MalyshkoA/agents-usage-and-limits-monitor/docs/images/desk-control.jpg

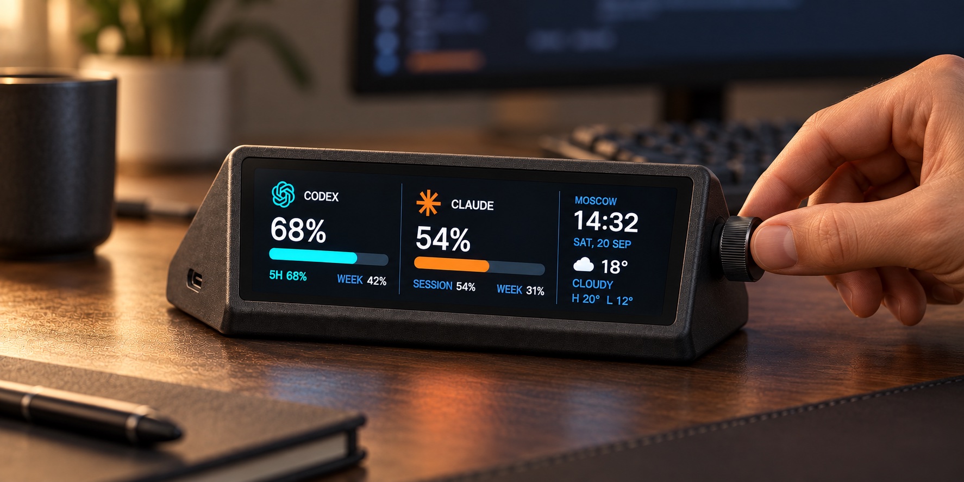
docs/images/desk-control.jpg
