MalyshkoA/agents-usage-and-limits-monitor/enclosure/exports-r4/asb-r4-board-mount.png

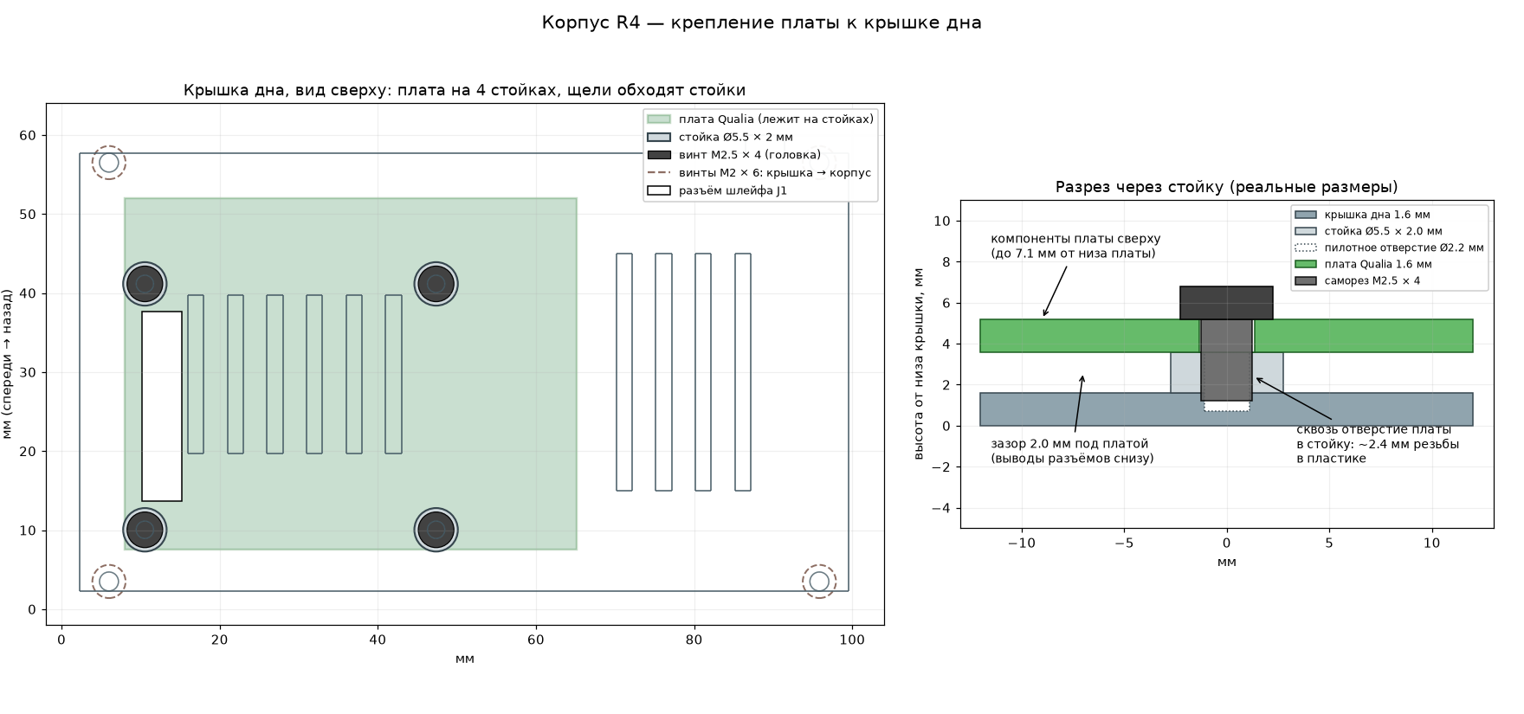
enclosure/exports-r4/asb-r4-board-mount.png
