MalyshkoA/agents-usage-and-limits-monitor/enclosure/exports-r4/asb-r4-fpc-niche.png

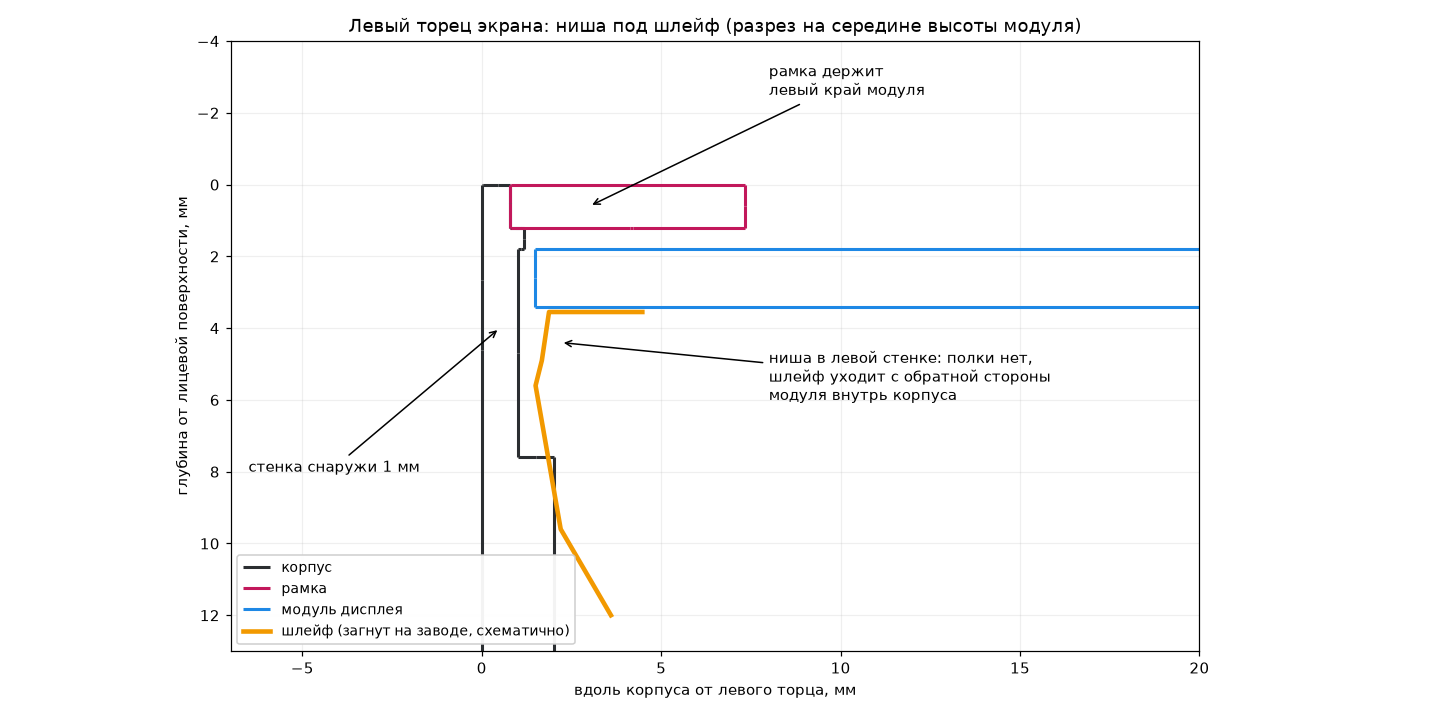
enclosure/exports-r4/asb-r4-fpc-niche.png
