MalyshkoA/agents-usage-and-limits-monitor/enclosure/exports-r4/asb-r4-assembly-preview.stl

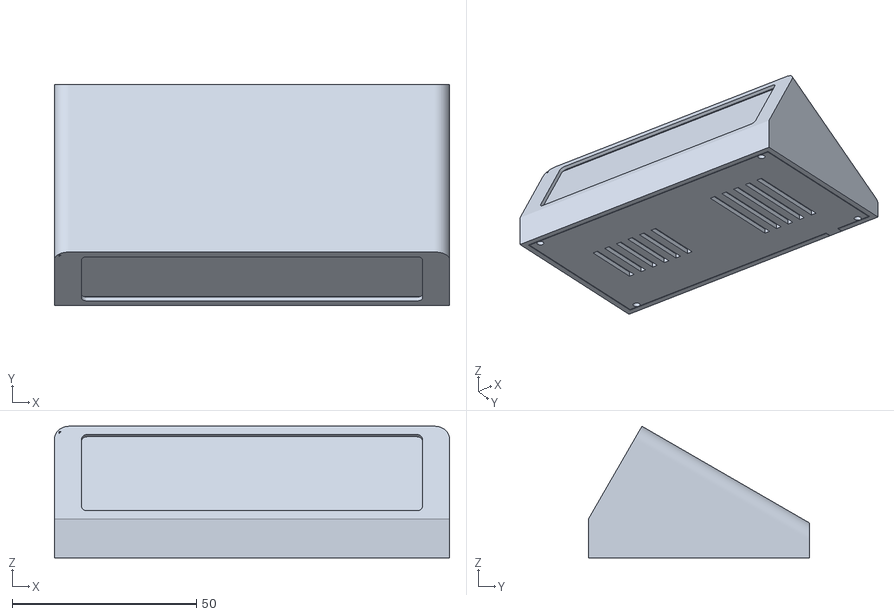
[picture p13: CAD file, 2026-10-25]
enclosure/exports-r4/asb-r4-assembly-preview.stl
107.1 x 60.0 x 35.7
