MalyshkoA/agents-usage-and-limits-monitor/enclosure/exports-r4/asb-r4-screen-bezel.stl

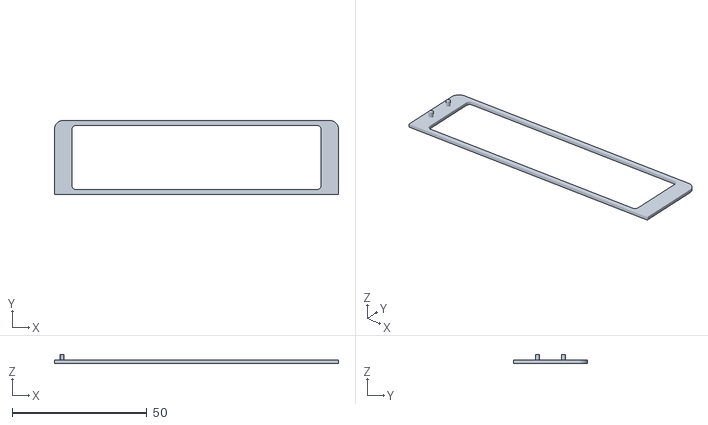
[picture p14: CAD file, 2026-10-25]
enclosure/exports-r4/asb-r4-screen-bezel.stl
105.5 x 27.5 x 3.20
