MalyshkoA/agents-usage-and-limits-monitor/enclosure/exports-r4/asb-r4-bottom-cover-pcb-tray.stl

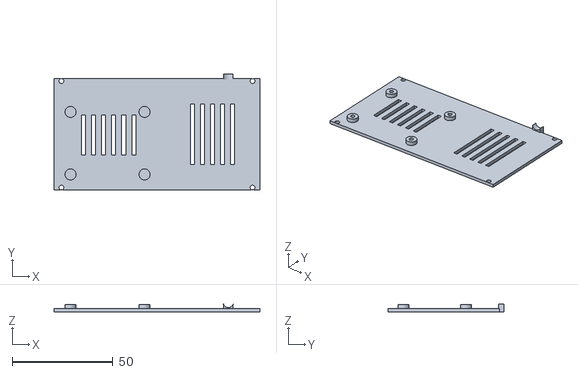
[picture p16: CAD file, 2026-10-25]
enclosure/exports-r4/asb-r4-bottom-cover-pcb-tray.stl
102.5 x 57.7 x 3.95
